emilerenaud/RoverSwitch/Project Outputs for roverSwitch/PDF/Bill of Materials.PDF

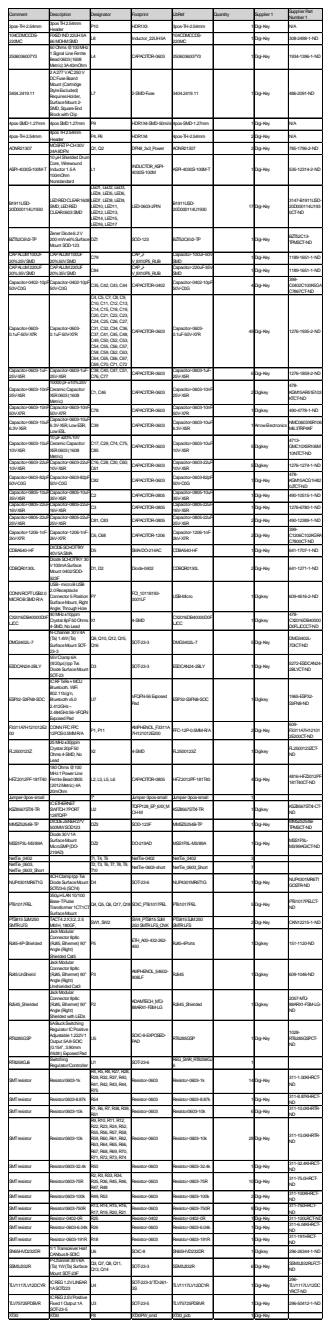
[picture p1: page 1]

Comment | Description | Designator | Footprint | LibRef | Quantity | Supplier 1 | Supplier Part Number 1

3pos-TH-2.54mm | 3posTH2.54mm Header | P10 | HDR1X3 | 3pos-TH-2.54mm | | 1 Digi-Key | N/A

104CDMCCDS-220MC | FIXEDIND22UH5A 66MOHMSMD | L8 | Inductor_22UH5A | 104CDMCCDS-220MC | | 1 Digi-Key | 308-2498-1-ND

2506036007Y3 | 60Ohms@100MHz 1Signal LineFerrite Bead0603(1608 Metric) 3A40mOhm | L4 | CAPACITOR-0603 | 2506036007Y3 | | 1 Digi-Key | 1934-1396-1-ND

3404.2419.11 | 2A277VAC250V DCFuseBoard Mount (Cartridge StyleExcluded) RequiresHolder, SurfaceMount 2-SMD,SquareEnd Blockwith Clip | L7 | 2-SMD-Fuse | 3404.2419.11 | | 1 Digi-Key | 486-2091-ND

4pos-SMD-1.27mm | 4posSMD1.27mm | P9 | HDR1X4-SMD-50mils 4pos-SMD-1.27mm | | | 1 Digi-Key | N/A

4pos-TH-2.54mm | 4posTH2.54mm Header | P4,P6 | HDR1X4 | 4pos-TH-2.54mm | | 2 Digi-Key | N/A

AONR21307 | MOSFETP-CH30V 24A8DFN | Q1, Q2 | DFN8_3x3_Power | AONR21307 | | 2 Digi-Key | 785-1796-2-ND

ASPI-4030S-100M-T | 10µHShieldedDrum Core, Wirewound Inductor 1.5A 100mOhm Nonstandard | L1 | INDUCTOR_ASPI-4030S-100M | ASPI-4030S-100M-T | | 1 Digi-Key | 535-12314-2-ND

B1911USD-20D000114U1930 | LEDREDCLEAR1608 SMD, LEDRED CLEAR0603SMD | LED1, LED2, LED3, LED4, LED5, LED6, LED7, LED8, LED9, LED10, LED11, LED12, LED13, LED14, LED15, LED16, LED17 | LED-0603-2PIN | B1911USD-20D000114U1930 | 17 Digi-Key | | 3147-B1911USD-20D000114U193 0CT-ND

BZT52C6V2-TP | Zener Diode6.2V 200mW±6%Surface Mount SOD-123 | DZ1 | SOD-123 | BZT52C6V2-TP | | 1 Digi-Key | BZT52C13-TPMSCT-ND

CAPALUM100UF 20%25VSMD | CAPALUM100UF 20%50VSMD | C79 | CAP_J-V_8X10P5_RUB | Capacitor-100uF-50V-SMD | | 1 Digi-Key | 1189-1651-1-ND

CAPALUM220UF 20%35VSMD | CAPALUM220UF 20%35VSMD | C84 | CAP_J-V_8X10P5_RUB | Capacitor-220uF-35V-SMD | | 1 Digi-Key | 1189-1651-1-ND

Capacitor-0402-10pF-50V-C0G | Capacitor-0402-10pF-50V-C0G | C35, C42, C43, C44 | CAPACITOR-0402 | Capacitor-0402-10pF-50V-C0G | | 4 Digi-Key | 399-C0402C100K5GA C7867CT-ND

Capacitor-0603-0.1uF-50V-X7R | Capacitor-0603-0.1uF-50V-X7R | C4, C5, C7, C8, C9, C10, C11, C12, C13, C14, C15, C18, C19, C20, C21, C22, C23, C24, C25, C26, C27, C31, C32, C34, C36, C37, C41, C45, C48, C49, C50, C52, C53, C54, C55, C56, C57, C58, C59, C62, C63, C64, C65, C66, C67, C69, C70, C71, C72 | CAPACITOR-0603 | Capacitor-0603-0.1uF-50V-X7R | 49 Digi-Key | | 1276-1935-2-ND

Capacitor-0603-1uF-25V-X5R | Capacitor-0603-1uF-25V-X5R | C38, C40, C47, C51, C76, C77 | CAPACITOR-0603 | Capacitor-0603-1uF-25V-X5R | | 6 Digi-Key | 1276-1859-2-ND

Capacitor-0603-10nF-25V-X5R | 10000pF±10%25V Ceramic Capacitor X5R0603(1608 Metric) | C1, C46 | CAPACITOR-0603 | Capacitor-0603-10nF-25V-X5R | | 2 Digikey | 478-KGM15AR51E103 KTCT-ND

Capacitor-0603-10nF-50V-X7R | Capacitor-0603-10nF-50V-X7R | C78 | CAPACITOR-0603 | Capacitor-0603-10nF-50V-X7R | | 1 Digikey | 490-4778-1-ND

Capacitor-0603-10uF-6.3V-X5R | Capacitor-0603-10uF-6.3V-X5R, LowESR, LowESL | C39 | CAPACITOR-0603 | Capacitor-0603-10uF-6.3V-X5R | | 1 ArrowElectronics | NMC0603X5R106 M6.3TRP4KF

Capacitor-0603-10uF-10V-X5R | 10µF±20%10V Ceramic Capacitor X5R0603(1608 Metric) | C17, C29, C74, C75, C85 | CAPACITOR-0603 | Capacitor-0603-10uF-10V-X5R | | 5 Digikey | 4713-GMC10X5R106M 10NTCT-ND

Capacitor-0603-22uF-10V-X5R | Capacitor-0603-22uF-10V-X5R | C16, C28, C30, C60, C61 | CAPACITOR-0603 | Capacitor-0603-22uF-10V-X5R | | 5 Digikey | 1276-1274-1-ND

Capacitor-0603-82pF-50V-C0G | Capacitor-0603-82pF-50V-C0G | C82 | CAPACITOR-0603 | Capacitor-0603-82pF-50V-C0G | | 1 Digi-Key | 478-KGM15ACG1H82 0JTCT-ND

Capacitor-0805-10uF-35V-X5R | Capacitor-0805-10uF-35V-X5R | C2 | CAPACITOR-0805 | Capacitor-0805-10uF-35V-X5R | | 1 Digi-Key | 490-10515-1-ND

Capacitor-0805-22uF-16V-X5R | Capacitor-0805-22uF-16V-X5R | C3 | CAPACITOR-0805 | Capacitor-0805-22uF-16V-X5R | | 1 Digi-Key | 1276-6780-1-ND

Capacitor-0805-22uF-25V-X5R | Capacitor-0805-22uF-25V-X5R | C81, C83 | CAPACITOR-0805 | Capacitor-0805-22uF-25V-X5R | | 2 Digi-Key | 490-12389-1-ND

Capacitor-1206-1nF-2kV-X7R | Capacitor-1206-1nF-2kV-X7R | C6, C68 | CAPACITOR-1206 | Capacitor-1206-1nF-2kV-X7R | | 2 Digi-Key | 399-C1206C102KGRA C7800CT-ND

CDBA540-HF | DIODESCHOTTKY 40V5ASMA | D5 | SMA/DO-214AC | CDBA540-HF | | 1 Digi-Key | 641-1707-1-ND

CDBQR0130L | DiodeSCHOTTKY 30 V100mASurface Mount 0402/SOD-923F | D1, D2 | Diode-0402 | CDBQR0130L | | 2 Digi-Key | 641-1271-1-ND

CONNRCPTUSB2.0 MICROBSMDR/A | USB- microBUSB 2.0Receptacle Connector 5Position SurfaceMount, Right Angle; ThroughHole | P7 | FCI_10118193-0001LF | USB-Micro | | 1 Digikey | 609-4616-2-ND

CX2016DB40000D0F LJCC | 40MHz±10ppm Crystal 8pF50Ohms 4-SMD, NoLead | X1 | 4-SMD | CX2016DB40000D0F LJCC | | 1 Digikey | 478-CX2016DB40000 D0FLJCCCT-ND

DMG3402L-7 | N-Channel 30V4A (Ta) 1.4W(Ta) SurfaceMount SOT-23-3 | Q9, Q10, Q12, Q15, Q16 | SOT-23-3 | DMG3402L-7 | | 5 Digi-Key | DMG3402L-7DICT-ND

ESDCAN24-2BLY | 55VClamp6A (8/20µs) IppTvs DiodeSurfaceMount SOT-23 | D3 | SOT-23-3 | ESDCAN24-2BLY | | 1 Digi-Key | 5272-ESDCAN24-2BLYCT-ND

ESP32-S3FN8-SOC | ICRFTxRx+MCU Bluetooth, WiFi 802.11b/g/n, Bluetooth v5.0 2.412GHz~ 2.484GHz56-VFQFN ExposedPad | U7 | VFQFN-56Exposed Pad | ESP32-S3FN8-SOC | | 1 Digikey | 1965-ESP32-S3FN8-ND

F3311A7H121012E2 00 | CONNFFCFPC 12POS0.5MMR/A | P1,P11 | AMPHENOL_F3311A 7H121012E200 | FFC-12P-0.5MM-R/A | | 2 Digi-Key | 609-F3311A7H12101 2E200CT-ND

FL2500123Z | 25MHz±30ppm Crystal 20pF50 Ohms4-SMD, No Lead | X2 | 4-SMD | FL2500123Z | | 1 Digikey | FL2500123ZCT-ND

HFZ2012PF-181T40 | 180Ohms@100 MHz1Power Line Ferrite Bead0805 (2012Metric) 4A 20mOhm | L2, L3, L5, L6 | CAPACITOR-0805 | HFZ2012PF-181T40 | | 4 Digi-Key | 4816-HFZ2012PF-181T40CT-ND

Jumper-3pos-small KSZ8567STXI-TR | ICETHERNET SWITCH7PORT 128TQFP | T* U2 | Jumper-3pos-small TQFP128_EP_6XX_M CH-M | Jumper-3pos-small KSZ8567STXI-TR | | 1 1 Digikey | KSZ8567STXI-CT-ND

MMSZ5254B-TP | DIODEZENER27V 500MWSOD123 | DZ3 | SOD-123F | MMSZ5254B-TP | | 1 Digi-Key | MMSZ5254B-TPMSCT-ND

MSS1P3L-M3/89A | Diode30V1A SurfaceMount MicroSMP(DO-219AD) | DZ2 | DO-219AD | MSS1P3L-M3/89A | | 1 Digi-Key | MSS1P3L-M3/89AGICT-ND

NetTie_0402 | | T1, T4, T5 | NetTie-0402 | NetTie_0402 | | 3
NetTie_0603, NetTie_0603_Short | | T2, T3, T6, T7, T8, T9, T10 | NetTie-0603-short | NetTie_0603_Short | | 7

NUP4301MR6T1G | 4CHClampIppTvs DiodeSurfaceMount SOT23-6(SC74) | D4 | SOT-23-6 | NUP4301MR6T1G | | 1 Digi-Key | NUP4301MR6T1 GOSTR-ND

PT61017PEL | 350µHLAN10/100 Base-TPulse Transformer 1CT:1CT SurfaceMount | Q4, Q5, Q6, Q17, Q18 SOIC_PT61017PEL | | PT61017PEL | | 5 Digi-Key | PT61017PELCT-ND

PTS815SJM250 SMTRLFS | TACT4.2X3.2, 2.5 MMH, 180GF, | SW1,SW2 | SW4_PTS815SJM 250SMTRLFS_CNK | PTS815SJM250 SMTRLFS | | 2 Digi-Key | CKN12215-1-ND

RJ45-4P-Shielded | JackModular Connector 8p8c (RJ45,Ethernet) 90° Angle(Right) ShieldedCat5 | P5 | ETH_A00-432-262-450 | RJ45-4Ports | | 1 Digikey | 151-1120-ND

RJ45UnShield | JackModular Connector 8p8c (RJ45,Ethernet) 90° Angle(Right) UnshieldedCat3 | P3 | AMPHENOL_54602-908LF | RJ545 | | 1 Digikey | 609-1046-ND

RJ545_Shielded | JackModular Connector 8p8c (RJ45,Ethernet) 90° Angle(Right) Shieldedwith LEDs | P2 | ADAMTECH_MTJ-88ARX1-FSM-LG | RJ545_Shielded | | 1 Digikey | 2057-MTJ-88ARX1-FSM-LG-ND

RT6285GSP | 5ABuckSwitching Regulator ICPositive Adjustable1.222V1 Output 5A8-SOIC (0.154", 3.90mm Width) ExposedPad | U5 | SOIC-8-EXPOSED-PAD | RT6285GSP | | 1 Digi-Key | 1028-RT6285GSPCT-ND

RT8258GJ6 | Switching Regulator/Controller | U1 | SOT-23-6 | REG_SWR_RT8258GJ 6 | | 1

SMTresistor | Resistor0603-1k | R4, R5, R8, R27, R28, R29, R32, R37, R40, R41, R42, R43, R44, R75 | Resistor-0603 | Resistor-0603-1k | 14 Digi-Key | | 311-1.00KHRCT-ND

SMTresistor | Resistor0603-8.87k | R54 | Resistor-0603 | Resistor-0603-8.87k | | 1 Digi-Key | 311-8.87KHRCT-ND

SMTresistor | Resistor0603-10k | R1, R6, R7, R38, R39, R51 | Resistor-0603 | Resistor0603-10k | | 6 Digi-Key | 311-10.0KHRTR-ND

SMTresistor | Resistor0603-10k | R9, R10, R11, R12, R22, R23, R24, R52, R55, R56, R57, R58, R59, R60, R61, R62, R63, R64, R65, R66, R67, R68, R69, R70, R71, R72, R73, R74 | Resistor-0603 | Resistor-0603-10k | 28 Digi-Key | | 311-10.0KHRTR-ND

SMTresistor | Resistor0603-32.4k | R50 | Resistor-0603 | Resistor-0603-32.4k | | 1 Digi-Key | 311-32.4KHRCT-ND

SMTresistor | Resistor0603-75R | R2, R3, R33, R34, R35, R36, R45, R46, R47, R48 | Resistor-0603 | Resistor-0603-75R | 10 Digi-Key | | 311-75.0HRCT-ND

SMTresistor | Resistor0603-100k | R49, R53 | Resistor-0603 | Resistor-0603-100k | | 2 Digi-Key | 311-100KHRCT-ND

SMTresistor | Resistor0603-750R | R13, R14, R15, R16, R17, R19, R20, R21 | Resistor-0603 | Resistor-0603-750R | | 8 Digi-Key | 311-750HRCT-ND

SMTresistor | Resistor-0603-6.04k Resistor-0402-0R | R26 R25 | Resistor-0603 Resistor-0402 | Resistor-0603-6.04k Resistor-0402-0R | | 1 Digi-Key | 311-6.04KHRCT-311-100LRCT-ND ND

SMTresistor | Resistor-0603-191R | R18 | Resistor-0603 | Resistor-0603-191R | 1 Digi-Key | 311-191HRCT-ND

SN65HVD232DR | 1/1Transceiver Half CANbus8-SOIC | U6 | SOIC-8 | SN65HVD232DR | 1 Digikey | 296-26344-1-ND

SSM3J332R | P-Channel 30V6A (Ta) 1W(Ta) Surface Mount SOT-23F | Q3, Q7, Q8, Q11, Q13, Q14 | SOT-23-3 | SSM3J332R | 6 Digi-Key | SSM3J332RLFCT-ND

TLV1117LV12DCYR | ICREG1.2VLINEAR 1ASOT223 | U4 | SOT-223-3/TO-261-3S | TLV1117LV12DCYR | 1 Digi-Key | 296-TLV1117LV12DC YRCT-ND

TLV75725PDBVR | ICREG2.5VPositive Fixed1Output 1A SOT-23-5 | U3 | SOT-23-5 | TLV75725PDBVR | 1 Digi-Key | 296-50412-1-ND

XT30 | XT30 | P8 | XT30PW_smd | XT30_pcb | 1 Digi-Key
