emilerenaud/RoverSwitch/CAD/casing_bot.SLDPRT

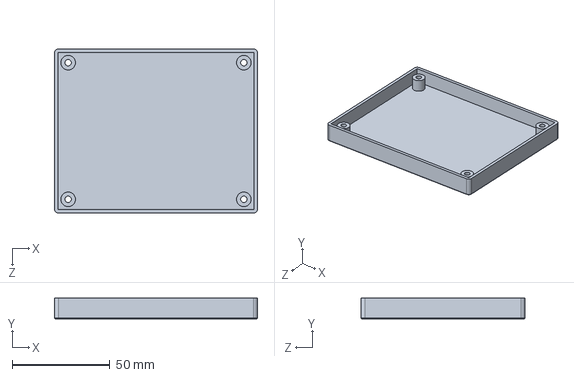
[picture p2: CAD file, 2025-01-24]
CAD/casing_bot.SLDPRT
104.0 x 10.6 x 84.0 mm
