emilerenaud/RoverSwitch/CAD/top_case.SLDPRT

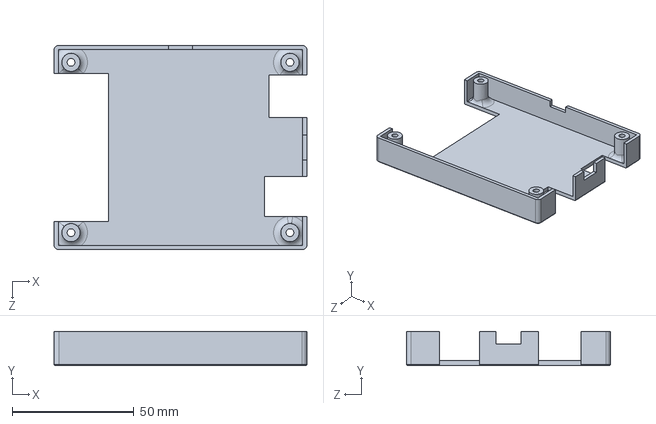
[picture p3: CAD file, 2025-01-24]
CAD/top_case.SLDPRT
104.0 x 14.0 x 84.0 mm
