emilerenaud/RoverSwitch/(list of files, cad)

Other CAD files:
CAD/STL/casing_bot.STL
CAD/STL/top_case.STL
