emilerenaud/RoverSwitch/Project Outputs for roverSwitch/PDF/Schematic Prints.PDF

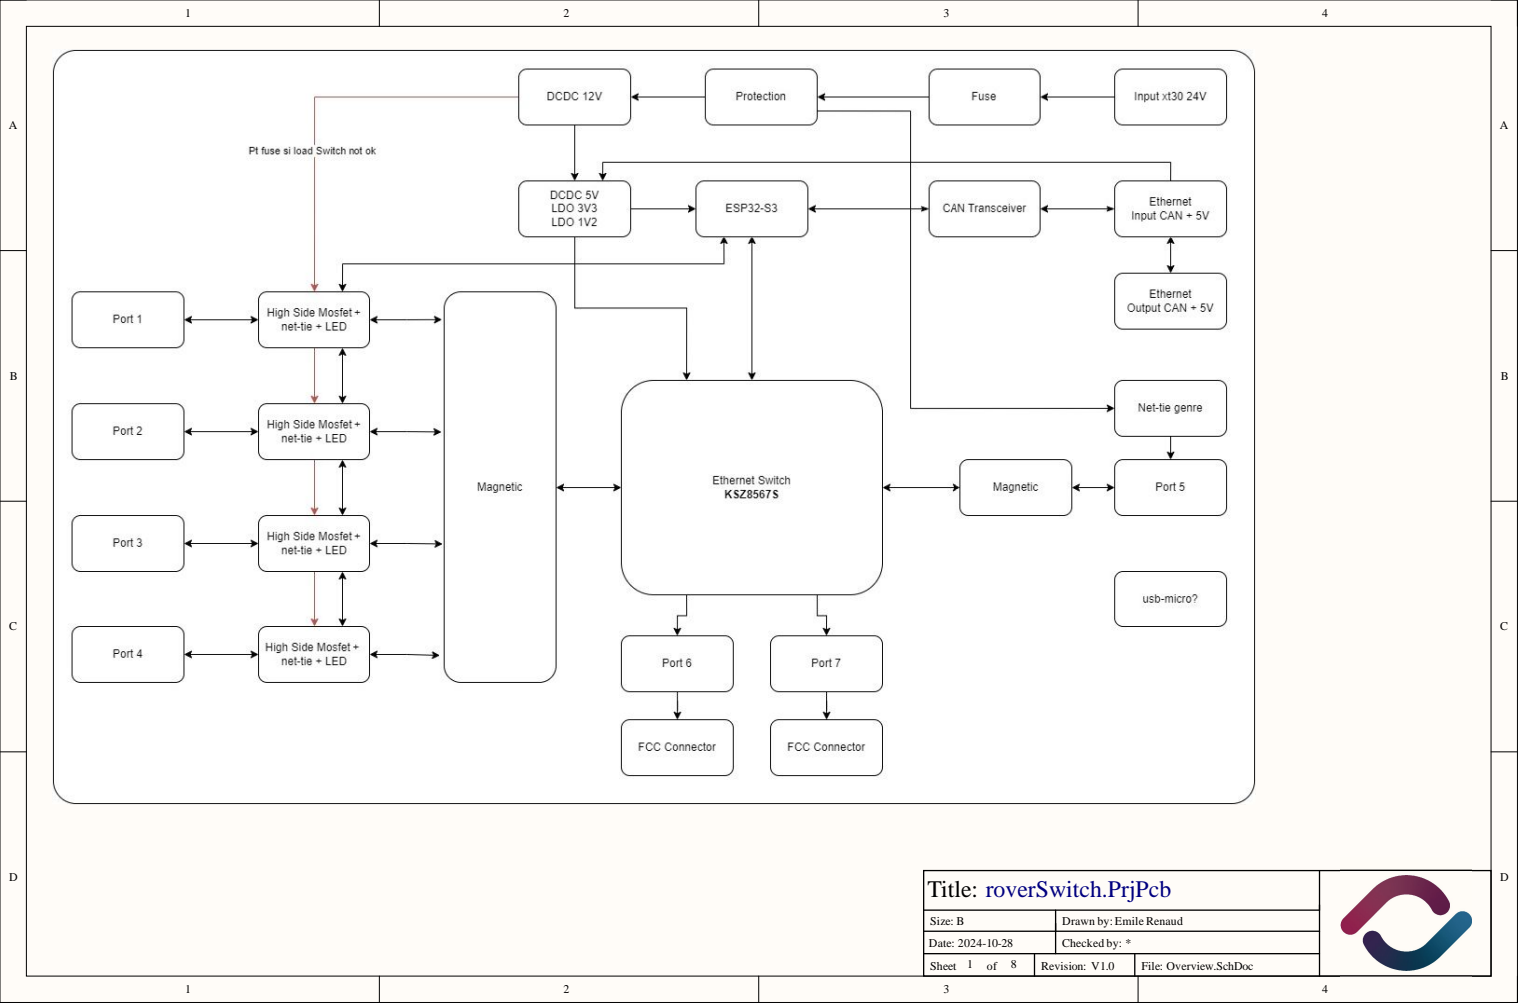
[picture p4: page 1]

Title: roverSwitch.PrjPcb

Size: B | Drawn by: Emile Renaud

Date: 2024-10-28 | Checked by: *

Sheet 1 of 8 | Revision: V1.0 | File: Overview.SchDoc

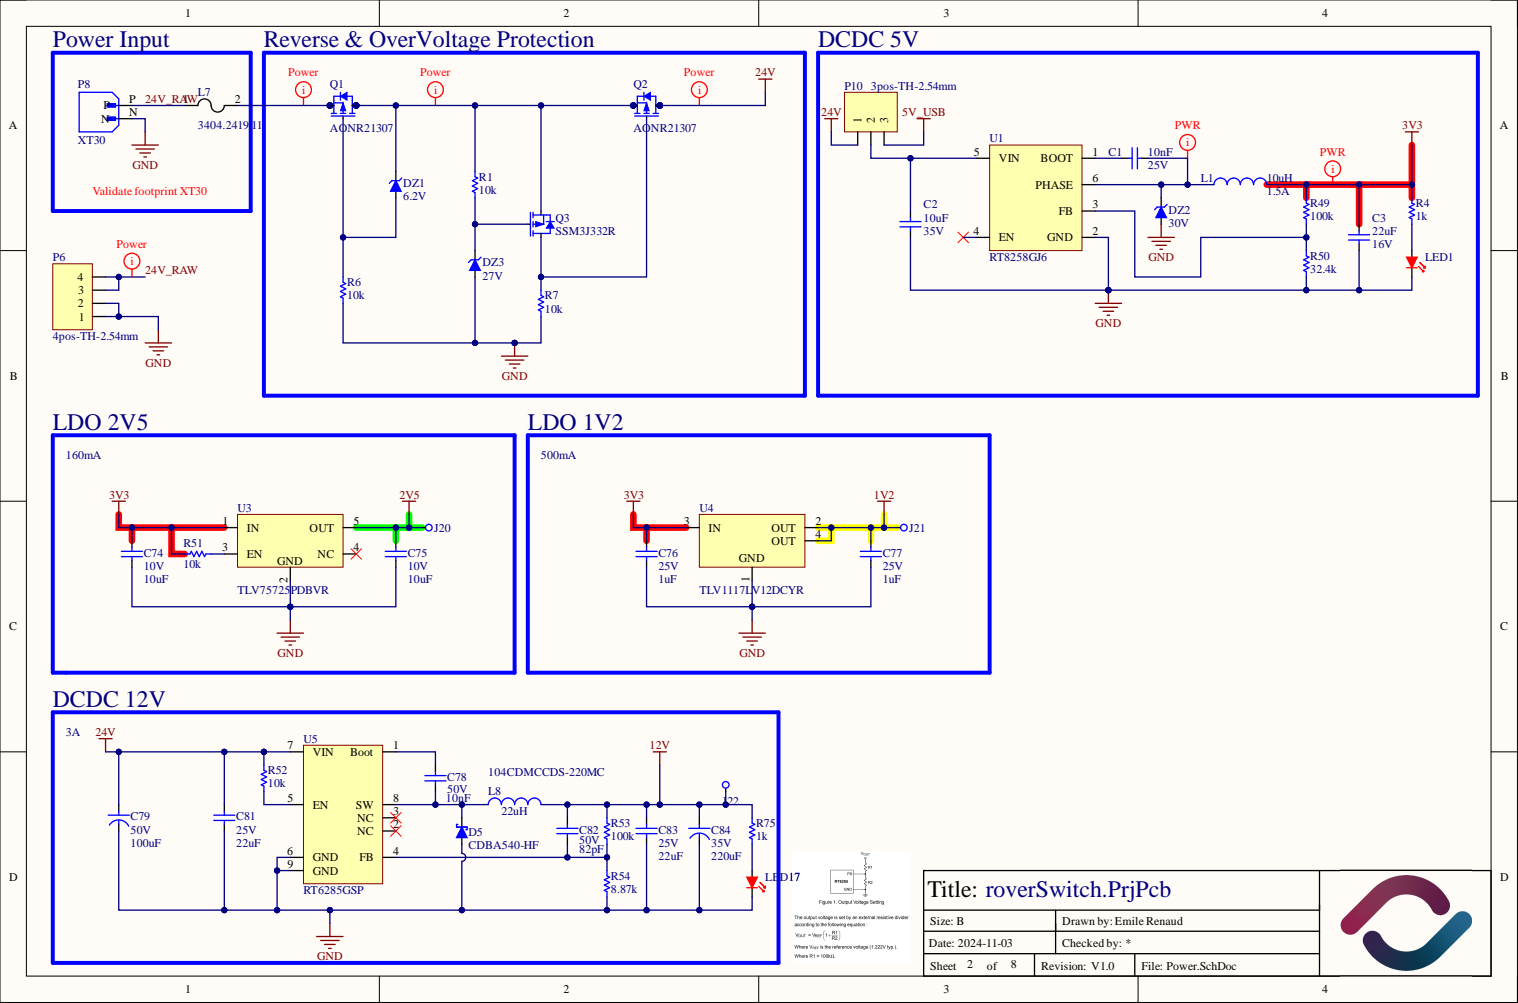
[picture p5: page 2]

Title: roverSwitch.PrjPcb

2 8 | V1.0 | Power.SchDoc

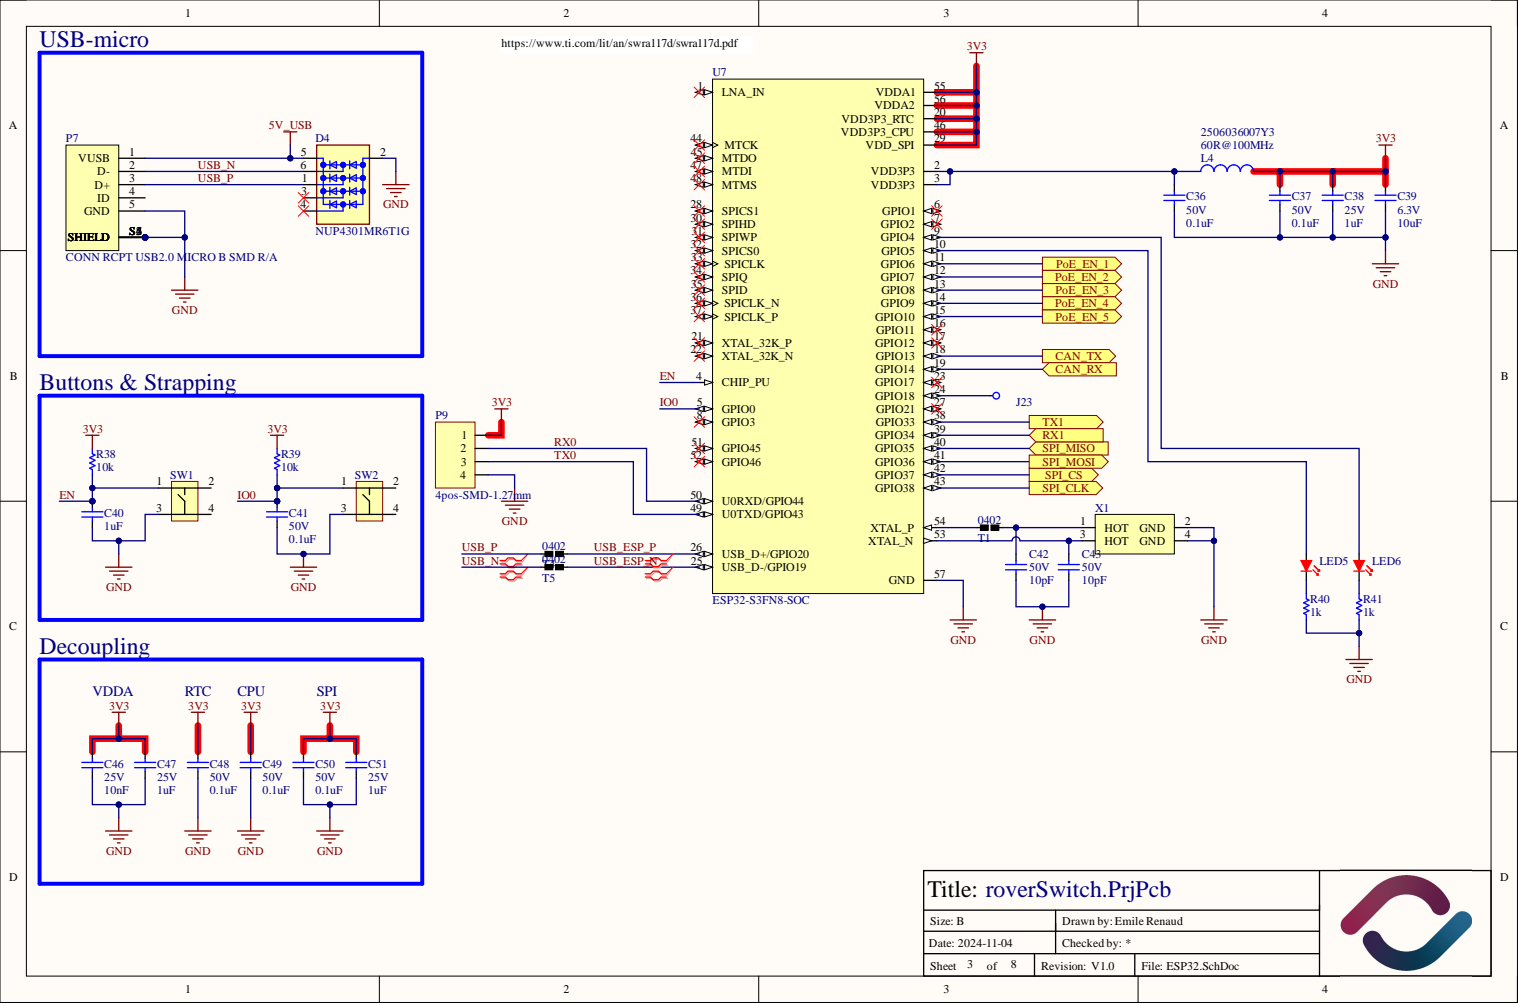
[picture p6: page 3]

https://www.ti.com/lit/an/swra117d/swra117d.pdf

CONN RCPT USB2.0 MICRO B SMD R/A

TX0 | GPIO46 52

U0RXD/GPIO44 50
U0TXD/GPIO43 49

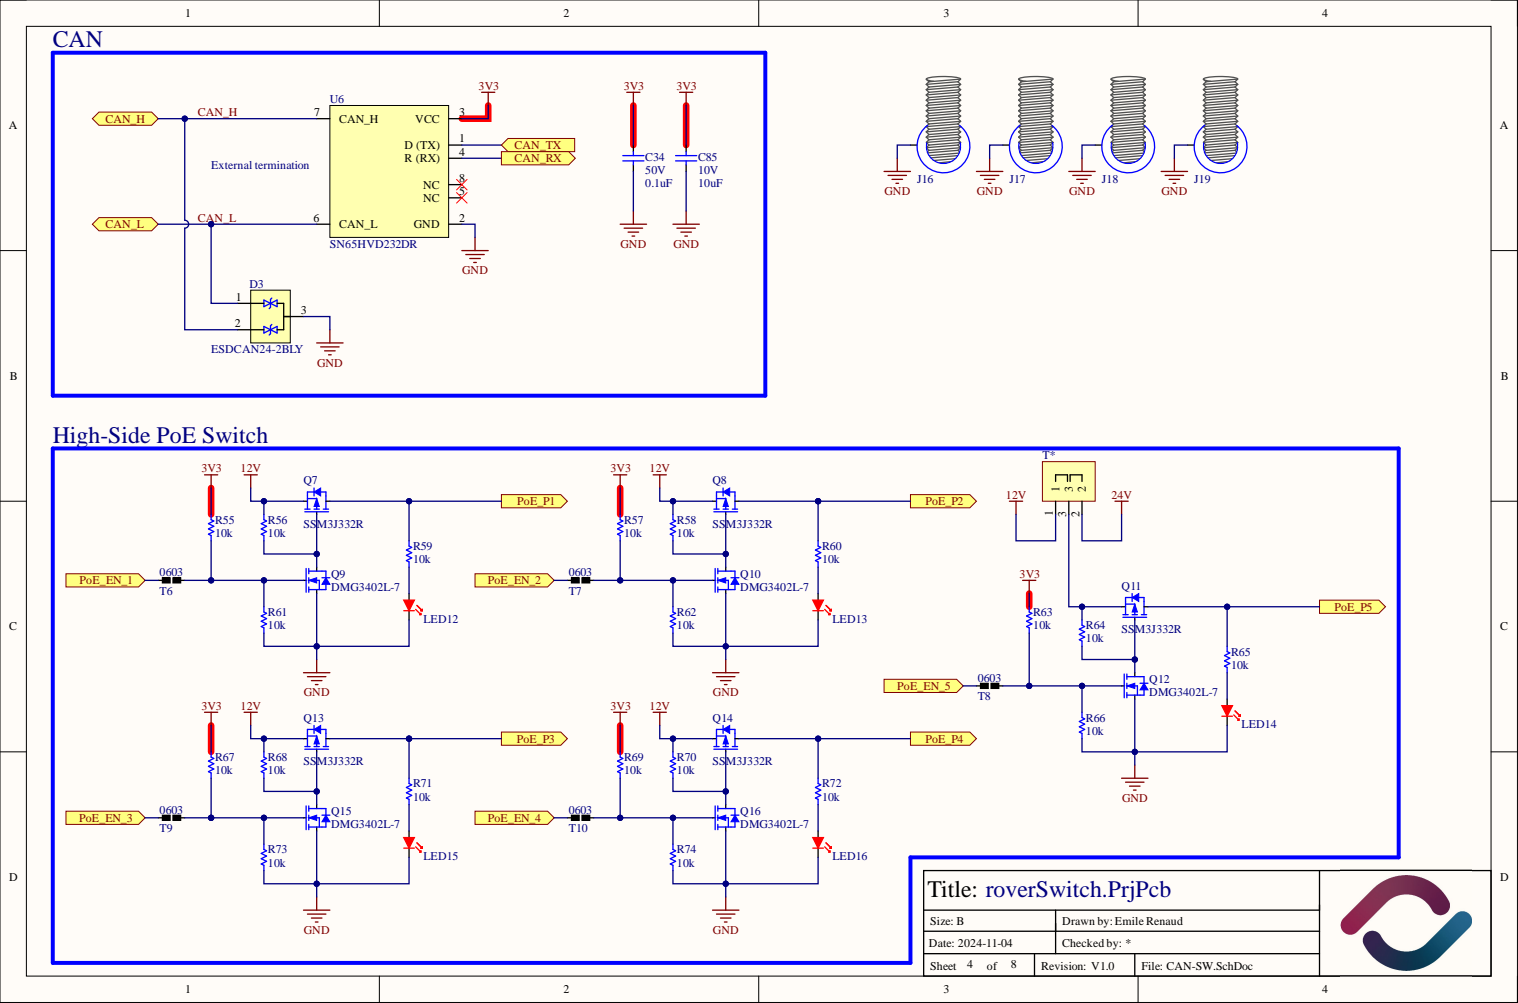
[picture p7: page 4]

High-Side PoE Switch

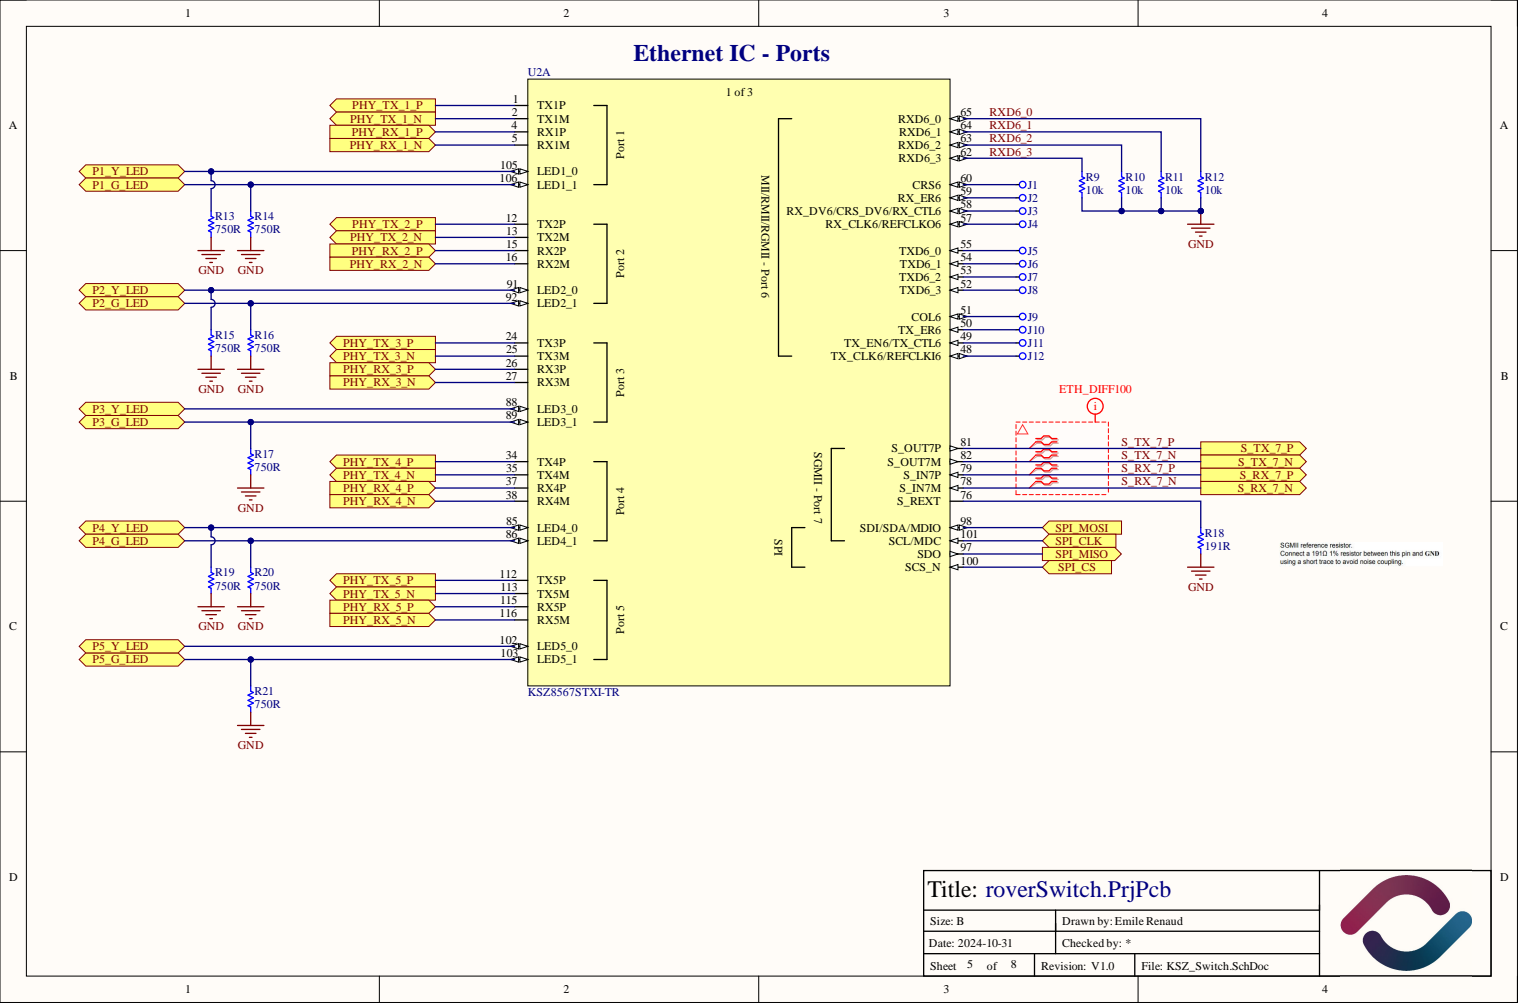
[picture p8: page 5]

RX D 6 _ 1
RX D 6 _ 2
6 RX D 6 _ 3

Port 1 Port 2 Port 3 Port 4 Port 5

MII/RMII/RGMII - Port 6

Title: B roverSwitch.PrjPcb

Size : | Draw n b y : Emi le Renau d

Dat e : 4-1 - | Checked b y : *

Shee t o f | Rev i s i o n : V . | Fi l e : KSZ _Sw i tch.Sc h D o c

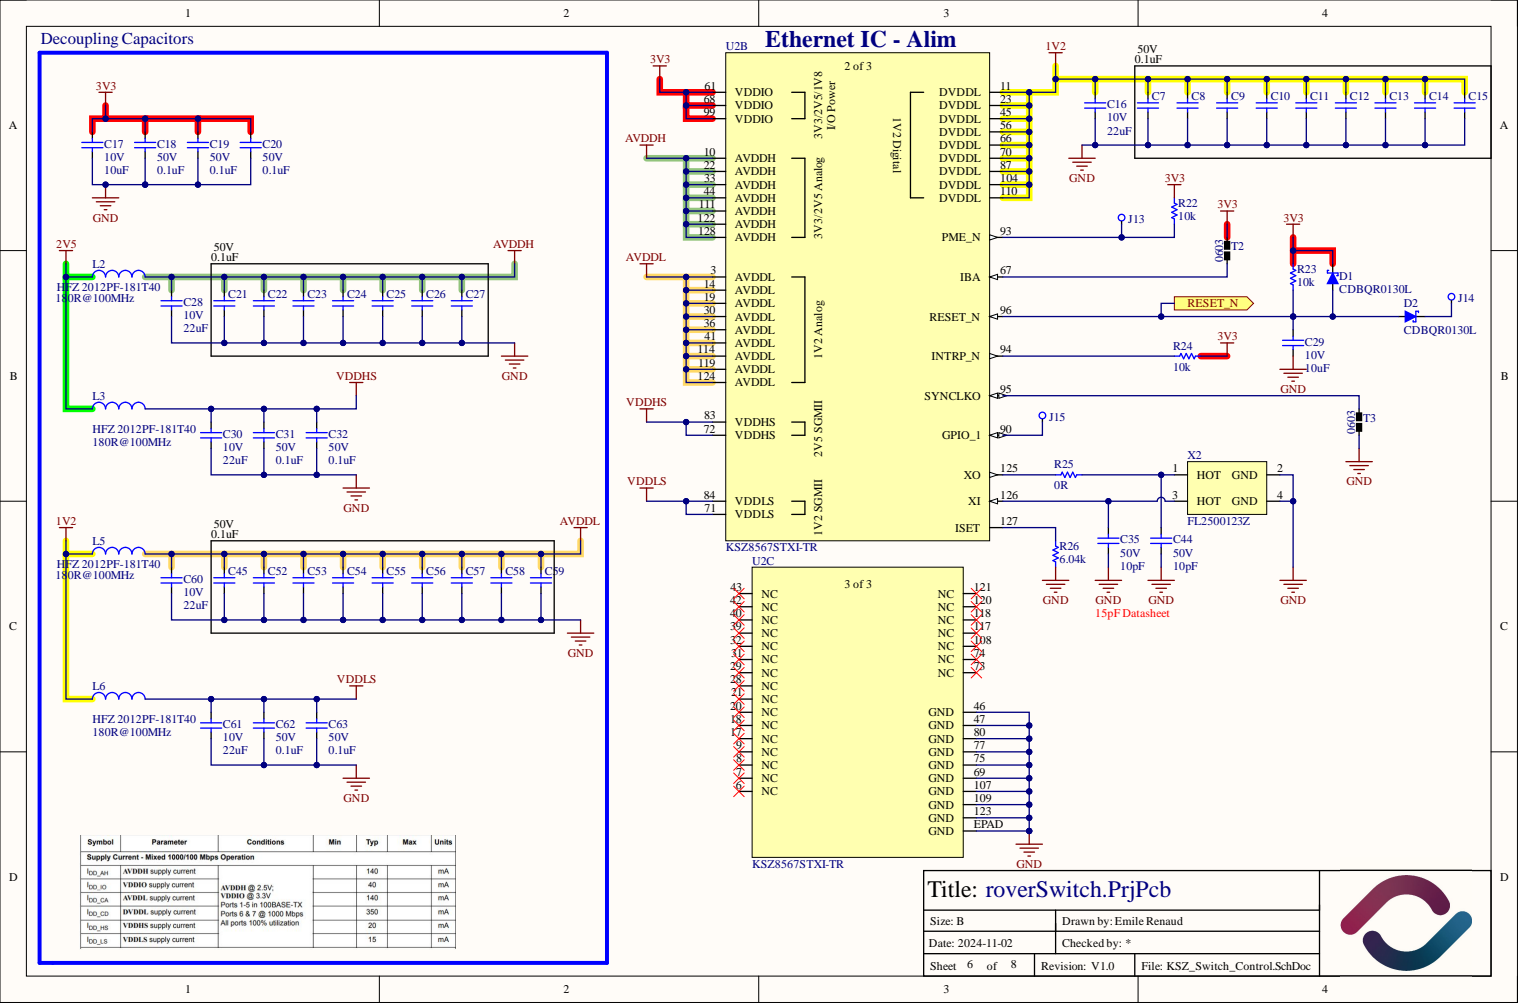
[picture p9: page 6]

AVDDH 33

AVDDH 111

AVDDL 19
AVDDL 30
AVDDL 36
AVDDL 41
AVDDL 114

AVDDL 124

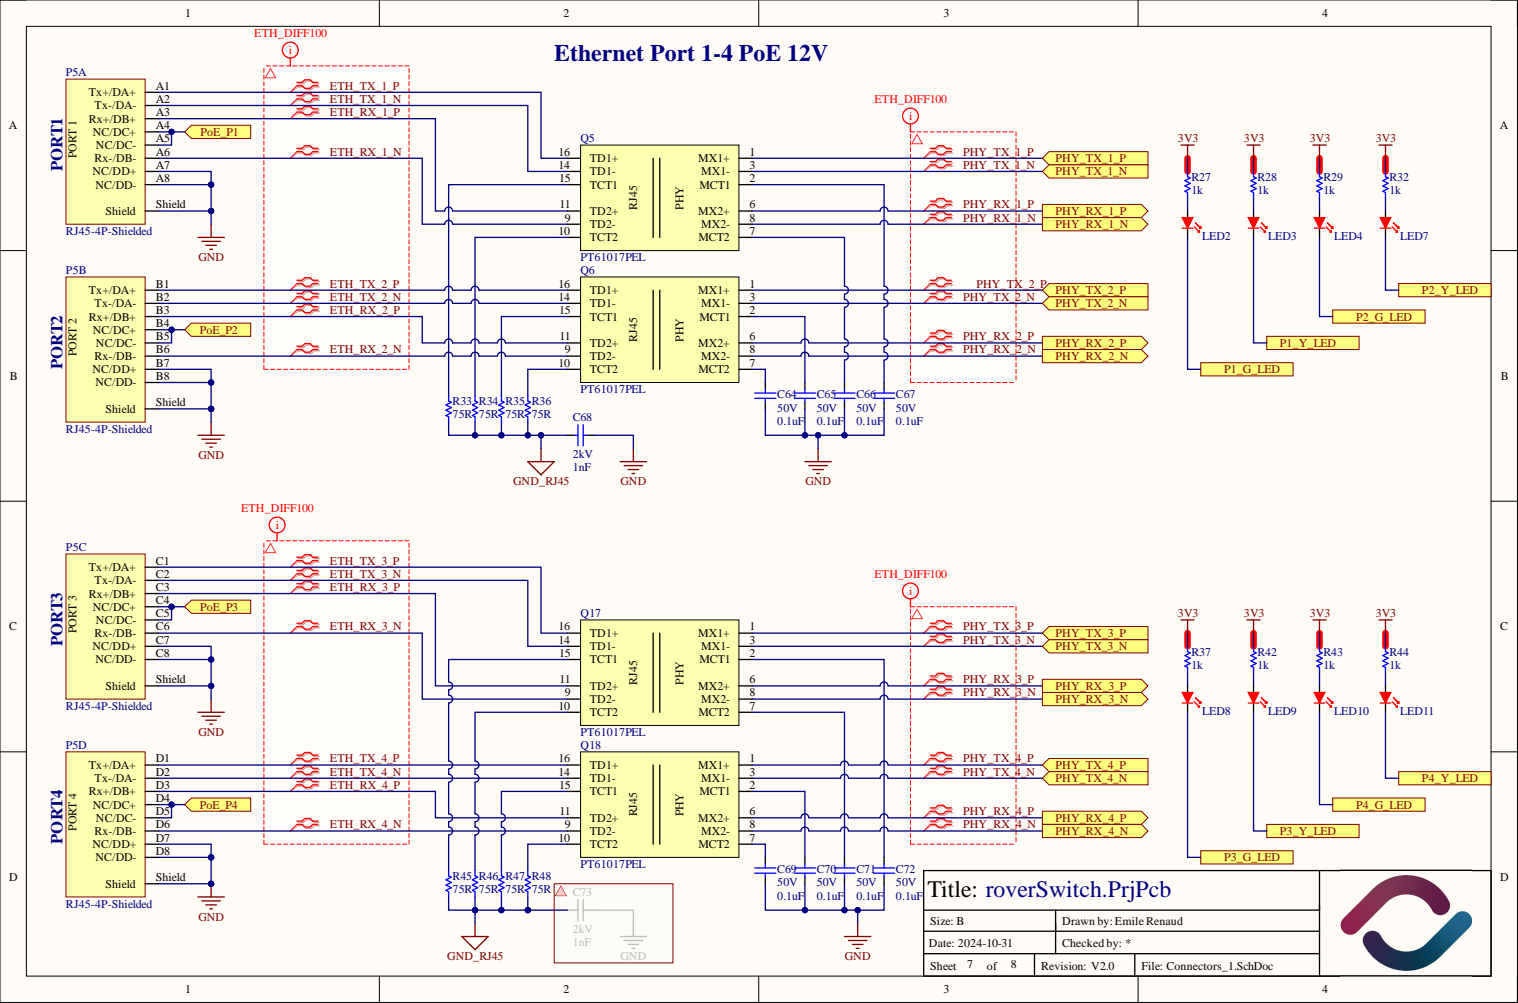
[picture p10: page 7]

A 2 | E T H _ T X_ 1 _N
A 3 | E T H _RX _ 1 _P
A 4 | | E T H _RX _ 1 _N

A 7 | 1 | 4
A 8 | | 1 5

Title: B roverSwitch.PrjPcb

Size : | Draw n b y : Emi le Renau d

Dat e : 4-1 - | Checked b y : *

Shee t o f | Rev i s i o n : V . 0 | Fi l e : Co n nect ors _ 1.S c h D o c

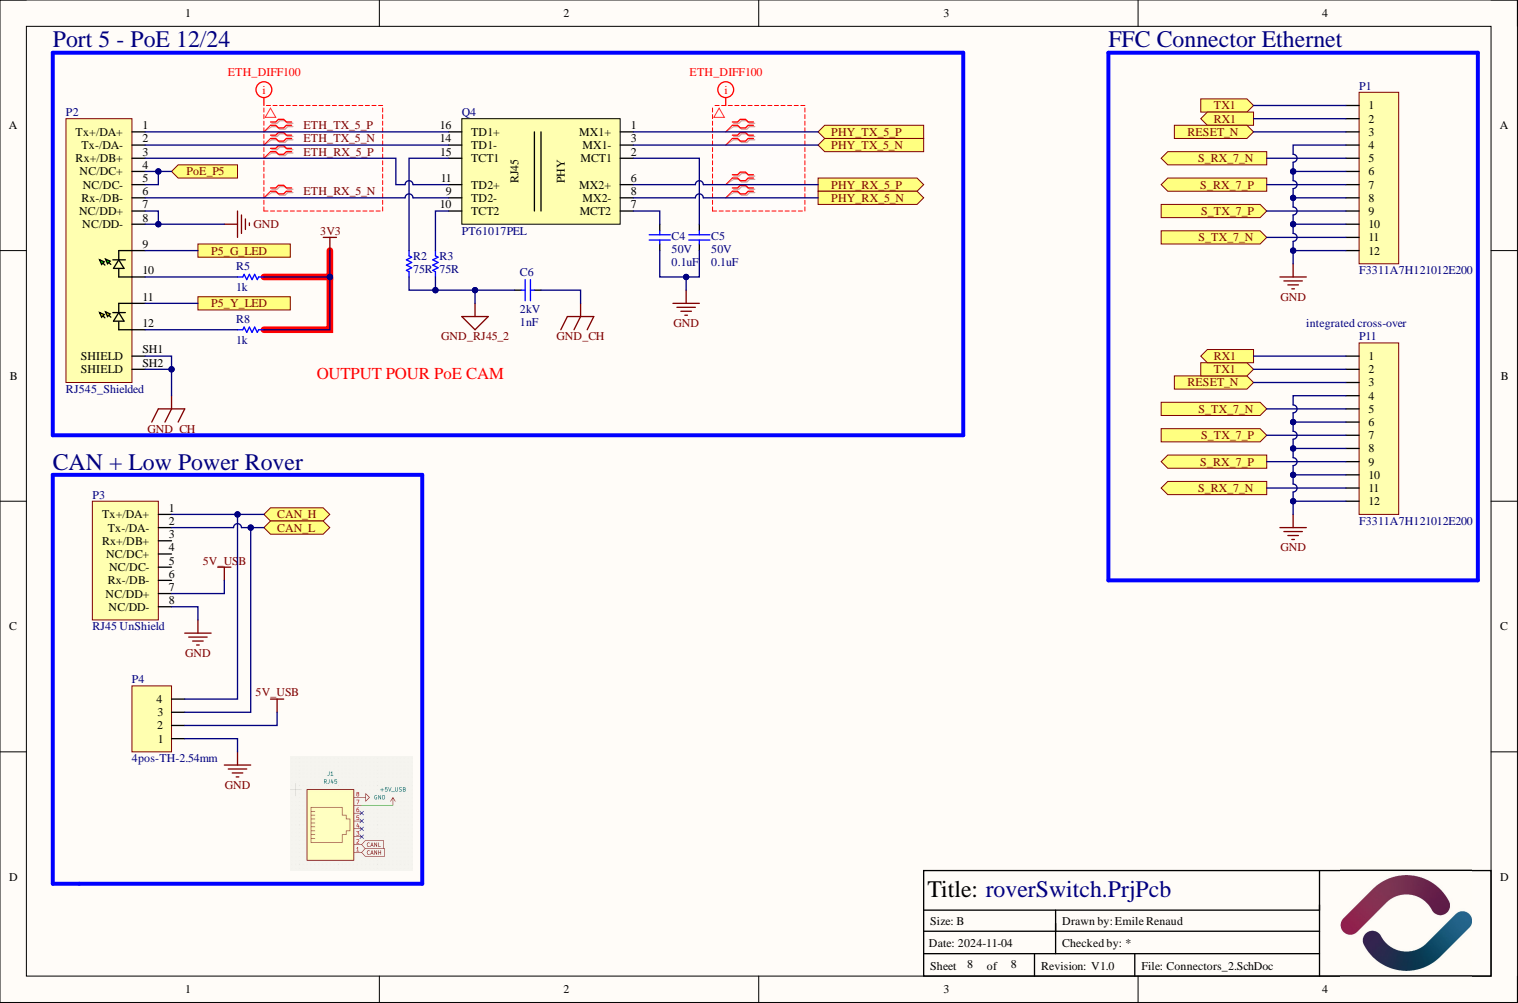
[picture p11: page 8]

OUTPUT POUR PoE CAM

CAN + Low Power Rover
