emilerenaud/RoverSwitch/(list of files, drawings)

Other design files:
CAN-SW.SchDoc
Connectors_1.SchDoc
Connectors_2.SchDoc
ESP32.SchDoc
KSZ_Switch.SchDoc
KSZ_Switch_Control.SchDoc
Overview.SchDoc
Power.SchDoc
roverSwitch.PcbDoc
roverSwitch.PrjPcb
