emilerenaud/RoverSwitch/(commit log)

2024-10-12 project template + basic schematic files
    [Connectors.SchDoc, KSZ_Switch.SchDoc, KSZ_Switch_Control.SchDoc, Overview.SchDoc, roverSwitch.PcbDoc, roverSwitch.PrjPcb]
2024-10-18 rj45 + mag
    [Connectors.SchDoc, Connectors_1.SchDoc, Connectors_2.SchDoc, roverSwitch.PrjPcb]
2024-10-22 leds + connectors
    [Connectors_1.SchDoc, Connectors_2.SchDoc, KSZ_Switch.SchDoc]
2024-10-23 KSZ almost done
    [Connectors_1.SchDoc, Connectors_2.SchDoc, KSZ_Switch.SchDoc, KSZ_Switch_Control.SchDoc]
2024-10-25 ESP, PoE SW
    [CAN-IO.SchDoc, CAN-SW.SchDoc, Connectors_1.SchDoc, Connectors_2.SchDoc, ESP32.SchDoc, KSZ_Switch.SchDoc, Overview.SchDoc, Power.SchDoc]
2024-10-25 add fuse
    [CAN-SW.SchDoc, Connectors_1.SchDoc, Connectors_2.SchDoc, KSZ_Switch.SchDoc, KSZ_Switch_Control.SchDoc, Power.SchDoc, roverSwitch.PrjPcb]
2024-10-28 add 12V dcdc
    [CAN-SW.SchDoc, Power.SchDoc]
2024-10-28 schematic done + pcb separation
    [CAN-SW.SchDoc, Connectors_1.SchDoc, Connectors_2.SchDoc, ESP32.SchDoc, KSZ_Switch.SchDoc, KSZ_Switch_Control.SchDoc, Overview.SchDoc, Power.SchDoc]
2024-10-28 note phil
    [CAN-SW.SchDoc, Connectors_1.SchDoc, Connectors_2.SchDoc, Power.SchDoc]
2024-10-29 start layout
    [CAN-SW.SchDoc, Connectors_1.SchDoc, Connectors_2.SchDoc, Power.SchDoc, roverSwitch.PrjPcb]
2024-10-31 routing ethernet
    [CAN-SW.SchDoc, Connectors_1.SchDoc, Connectors_2.SchDoc, ESP32.SchDoc, KSZ_Switch.SchDoc, Power.SchDoc, roverSwitch.PrjPcb]
2024-10-31 routing cap ethernet
    [Connectors_2.SchDoc]
2024-11-02 power net color + polygon power switch
    [KSZ_Switch_Control.SchDoc, Power.SchDoc, roverSwitch.PrjPcb]
2024-11-04 routing signal done
    [CAN-SW.SchDoc, ESP32.SchDoc]
2024-11-04 silkscreen + groundplane + DRC ok
2025-01-24 step + CAD casing + soft
    [Power.SchDoc, casing_bot.SLDPRT, casing_bot.STL, top_case.SLDPRT, top_case.STL]
2025-02-24 base code KSZ + toggle PoE 24V
